OscarSR27/Neuro-inspired-Systems-Engineering-Project-1/photos_videos/mediapipe_to_VTM.jpg

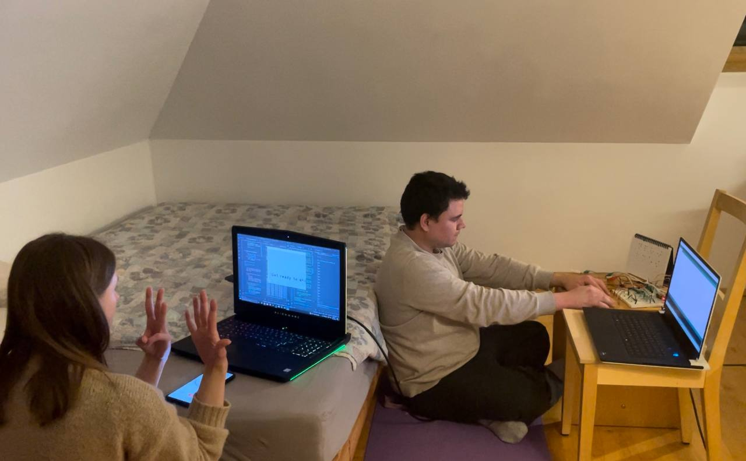
photos_videos/mediapipe_to_VTM.jpg
