OscarSR27/Neuro-inspired-Systems-Engineering-Project-1/photos_videos/Whole_system_and_laptop.jpg

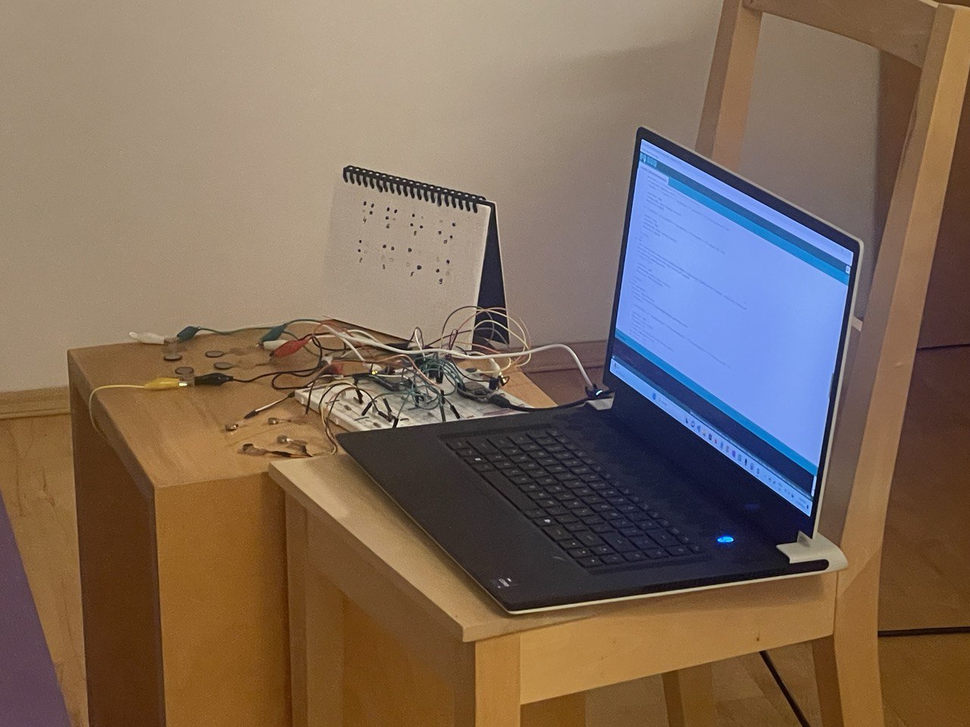
photos_videos/Whole_system_and_laptop.jpg
