OscarSR27/Neuro-inspired-Systems-Engineering-Project-1/Documentation/NISE_project-1_outline.pptx

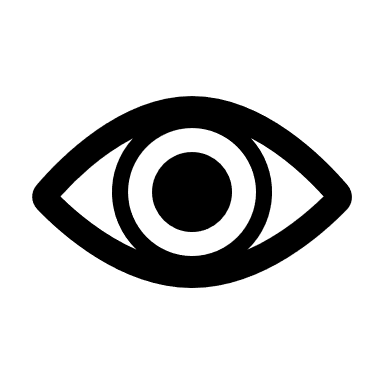
[picture p15: figure]
Auge mit einfarbiger Füllung
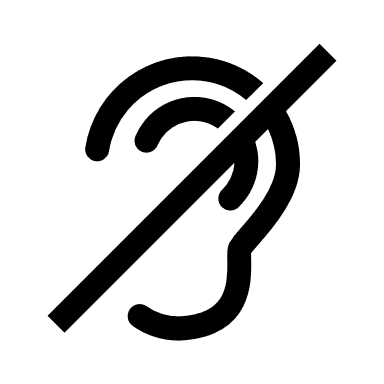
[picture p16: figure]
Taub mit einfarbiger Füllung
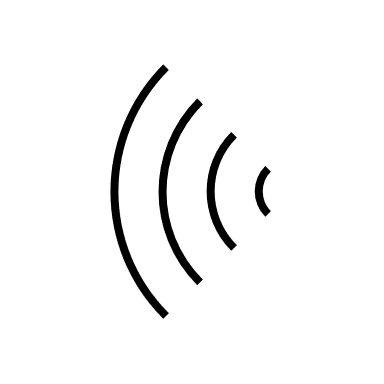
[picture p17: figure]
WLAN Silhouette
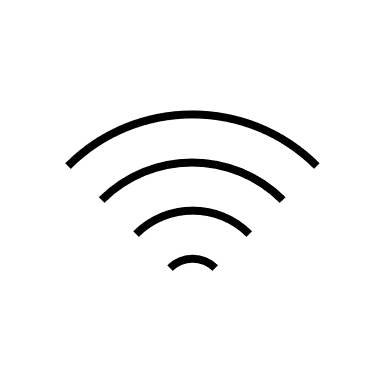
[picture p18: figure]
WLAN Silhouette
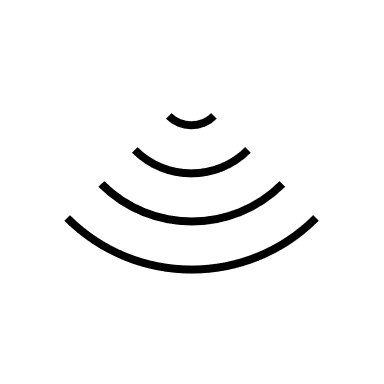
[picture p19: figure]
WLAN Silhouette
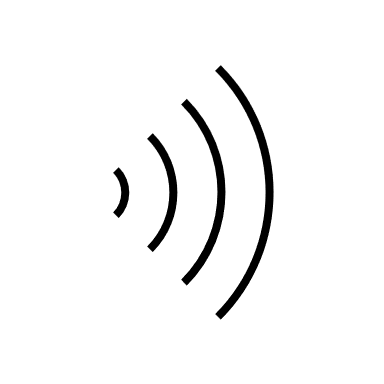
[picture p20: figure]
WLAN Silhouette

5

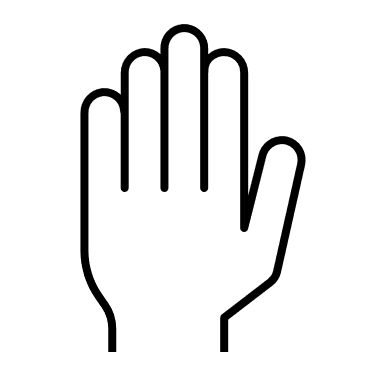
[picture p21: figure]
Erhobene Hand Silhouette
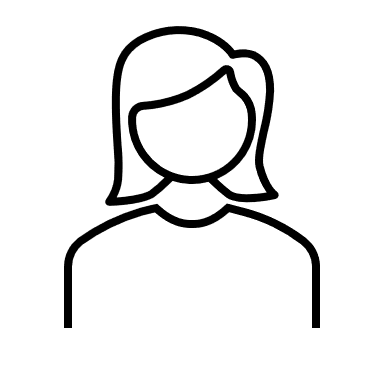
[picture p22: figure]
Weibliches Profil Silhouette
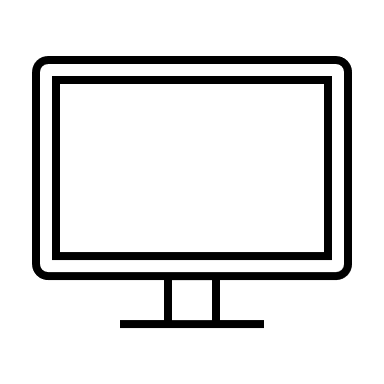
[picture p23: figure]
Monitor Silhouette
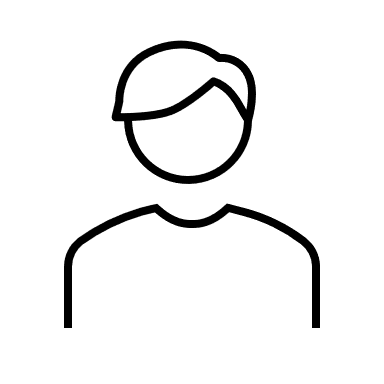
[picture p24: figure]
Männliches Profil Silhouette
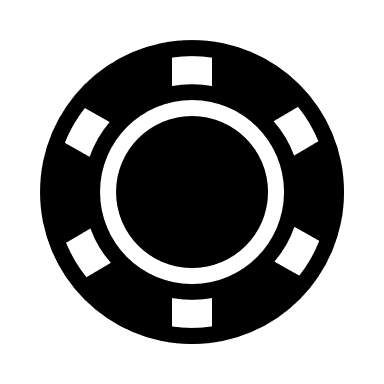
[picture p25: figure]
Glücksspielchips mit einfarbiger Füllung
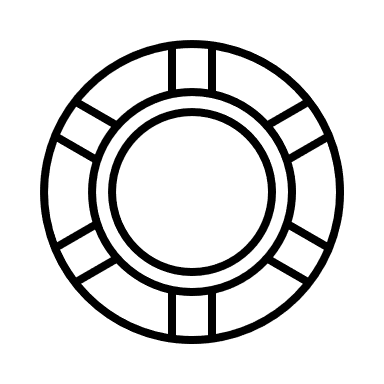
[picture p26: figure]
Glücksspielchips Silhouette

0
