OscarSR27/Neuro-inspired-Systems-Engineering-Project-1/data-analysis/plots/itr-with-acc/ACC_ITR_force_sensor_learning_curve.pdf

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

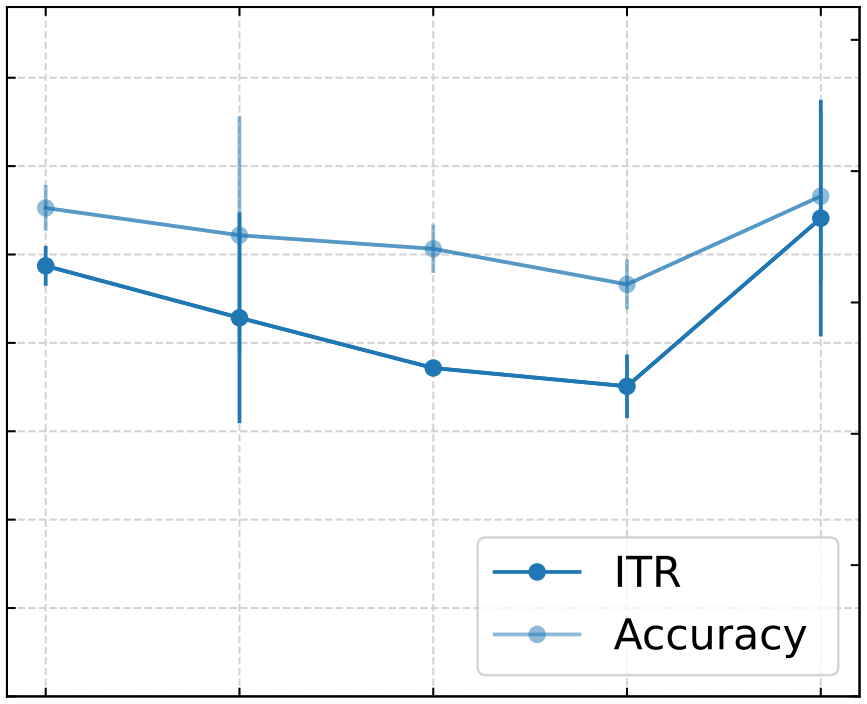
[picture p28: figure]
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
