OscarSR27/Neuro-inspired-Systems-Engineering-Project-1/data-analysis/plots/itr/ITR_force_sensor_pressure_threshold_optimization.pdf

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

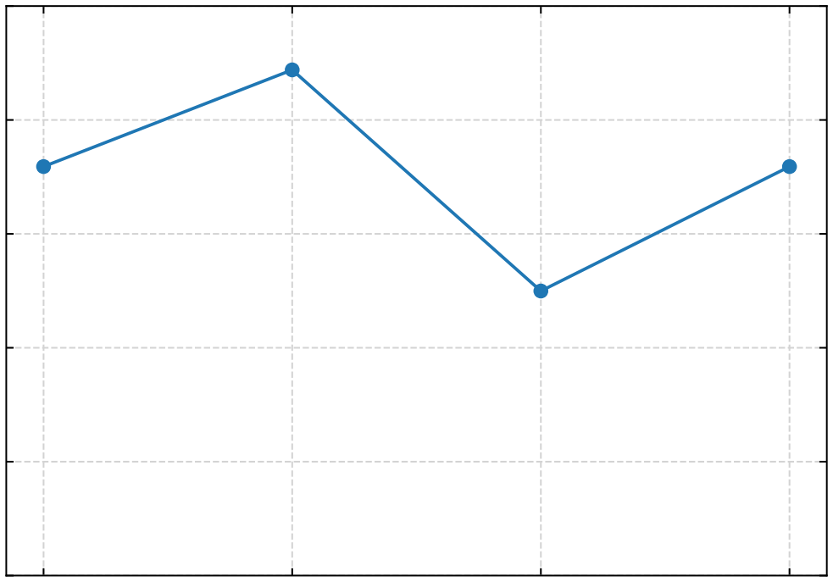
[picture p31: figure]
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
