OscarSR27/Neuro-inspired-Systems-Engineering-Project-1/data-analysis/plots/itr/ITR_force_sensor_sample_size_optimization.pdf

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

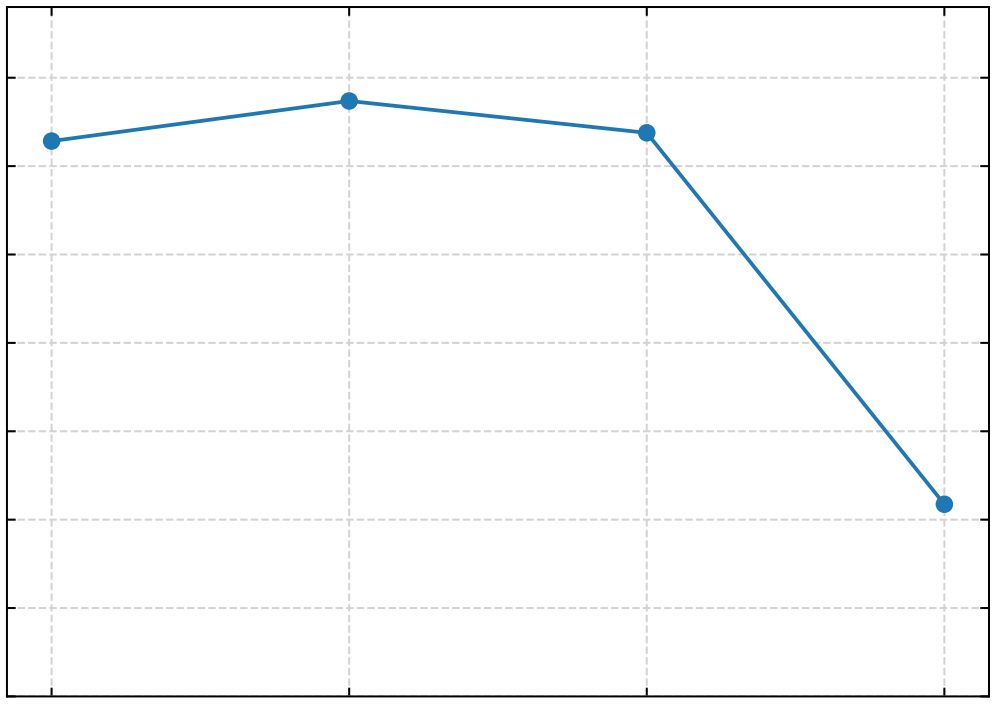
[picture p32: figure]
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
