OscarSR27/Neuro-inspired-Systems-Engineering-Project-1/data-analysis/plots/itr/ITR_vibrotactile_motors_parameter_optimization_simultaneous.pdf

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

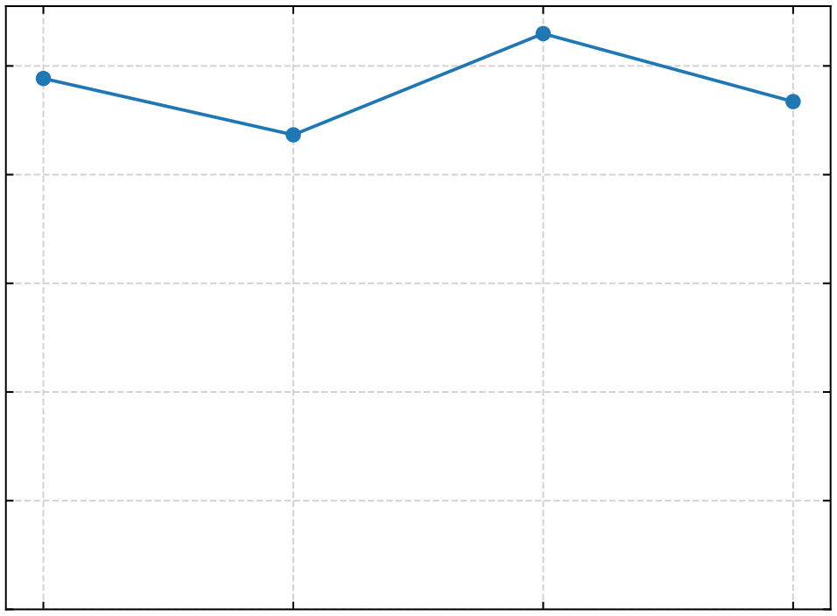
[picture p34: figure]
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
