OscarSR27/Neuro-inspired-Systems-Engineering-Project-1/photos_videos/FSR_to_mediapipe.jpg

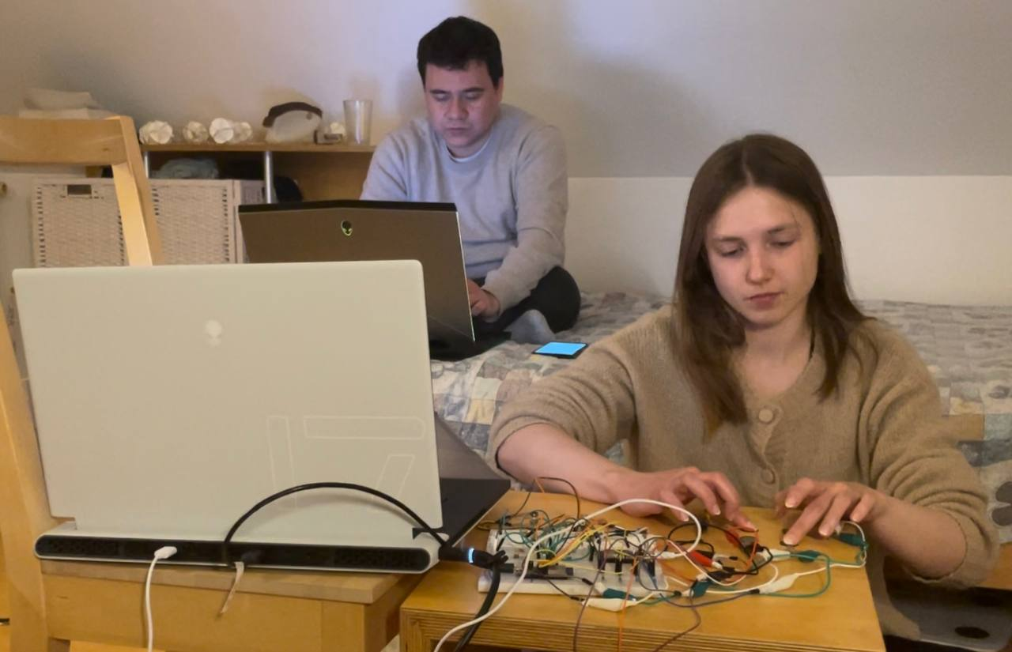
photos_videos/FSR_to_mediapipe.jpg
