OscarSR27/Neuro-inspired-Systems-Engineering-Project-1/photos_videos/FSRs.jpg

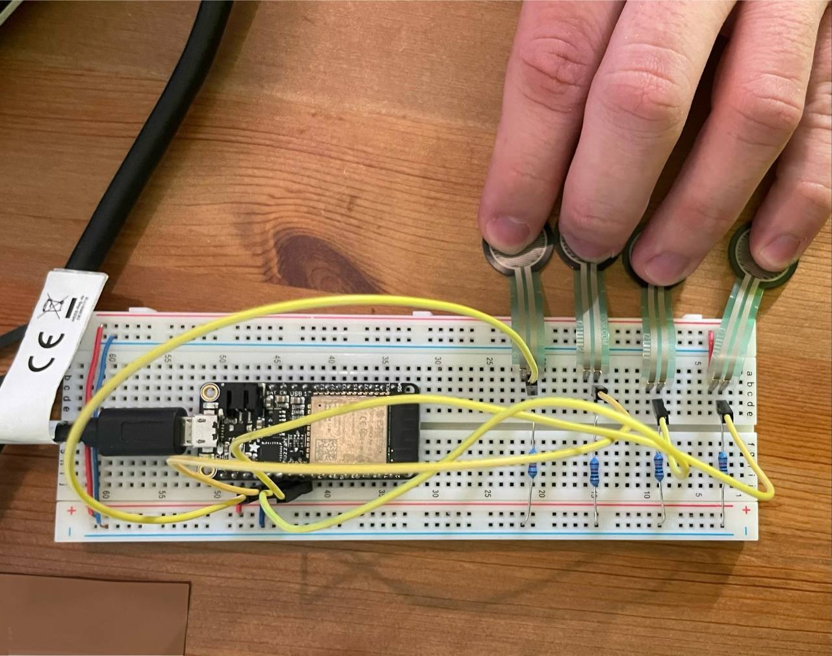
photos_videos/FSRs.jpg
