OscarSR27/Neuro-inspired-Systems-Engineering-Project-1/photos_videos/Whole_system.jpg

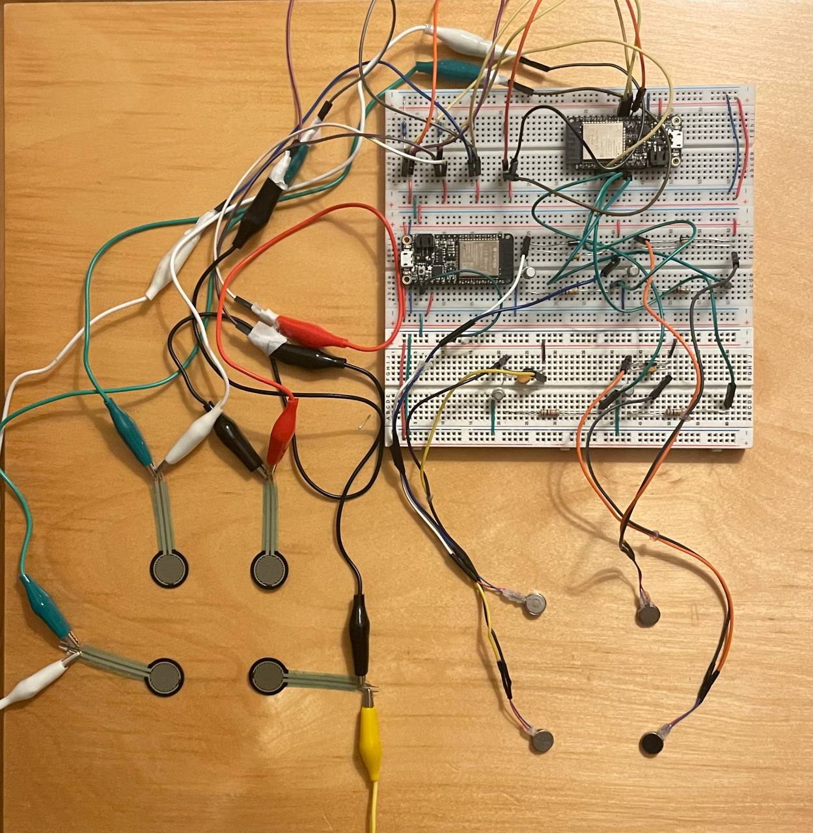
photos_videos/Whole_system.jpg
