OscarSR27/Neuro-inspired-Systems-Engineering-Project-1/photos_videos/whole_system_and_laptop_2.jpg

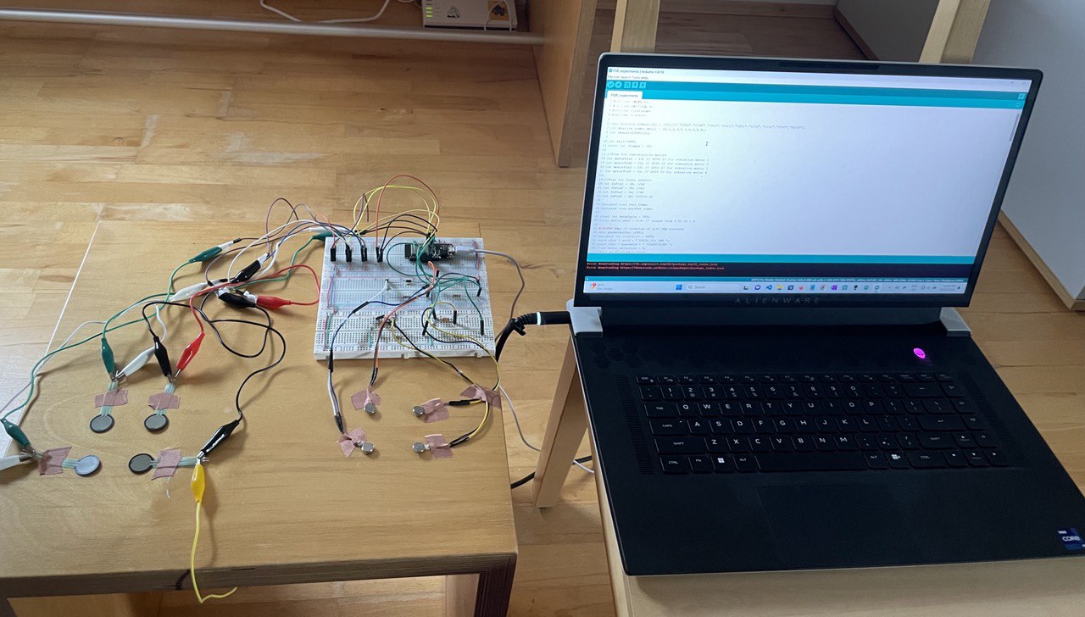
photos_videos/whole_system_and_laptop_2.jpg
