OscarSR27/Neuro-inspired-Systems-Engineering-Project-1/mediapipe/Experiment_data/subject_id0_sample_size15.csv

ground_truth | response
2 | 5
0 | 4
6 | 4
4 | 4
7 | 0
6 | 0
