OscarSR27/Neuro-inspired-Systems-Engineering-Project-1/data-analysis/accuracy_results/ACC_vibrotactile_motors_learning_curve.txt

id,pre_train,session1,session2,session3,post_train
0,0.65625,0.9148936170212766,0.88,0.9272727272727272,0.967741935483871
1,1.0,1.0,1.0,0.9803921568627451,0.9814814814814815
