OscarSR27/Neuro-inspired-Systems-Engineering-Project-1/data-analysis/itr_results/ITR_vibrotactile_motors_learning_curve.txt

id,pre_train,session1,session2,session3,post_train
0,20.8624688519472,61.85731443863901,60.30440573567301,74.67262670486284,93.43647818632834
1,73.08241808752197,76.40434618240933,81.38723832474038,79.57376244300156,84.51502554874877
