OscarSR27/Neuro-inspired-Systems-Engineering-Project-1/data-analysis/plots/itr/ITR_vibrotactile_motors_learning_curve.pdf

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

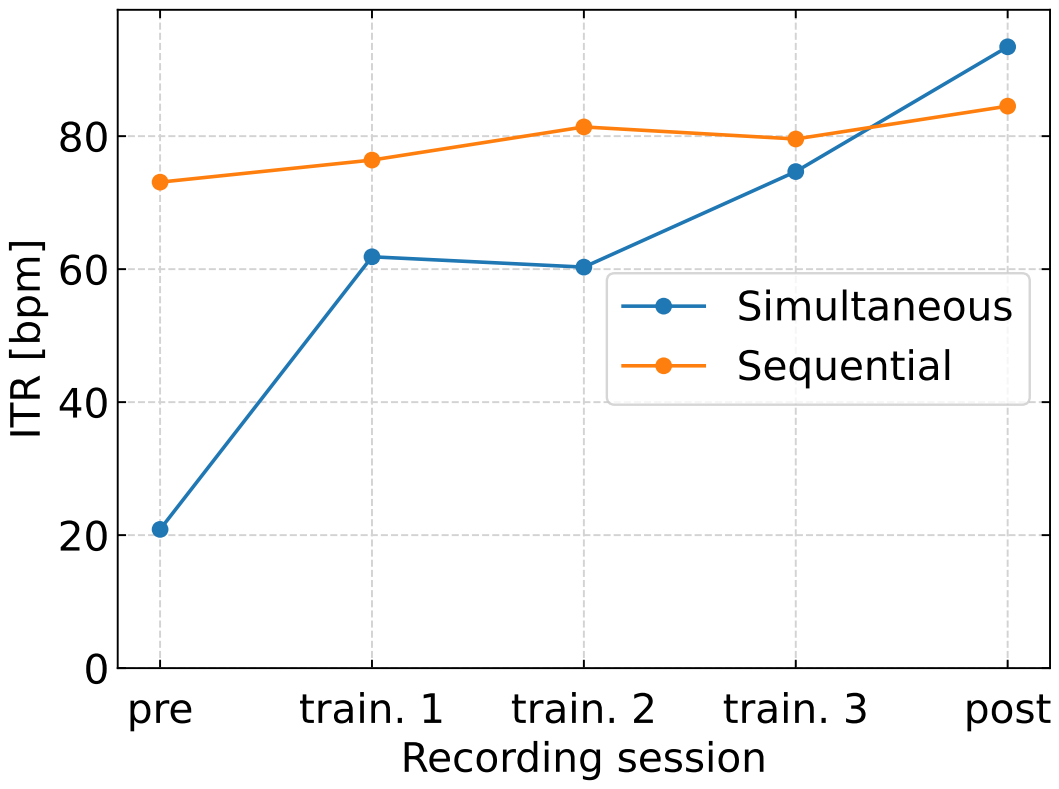
[picture p43: page 1]
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
