OscarSR27/Neuro-inspired-Systems-Engineering-Project-1/(commit log)

2023-11-26 connected python to force sensors
2023-11-26 Update ForceSensors.ino
    Update pin for force sensors
2023-11-26 Motor experiments
    Add motor experiments
2023-11-26 preliminary data analysis on dummy data
    [dummy_data_1.csv, dummy_data_2.csv]
2023-11-26 Add force sensors experiment
2023-11-26 Update motor experiments, add 2min stop
2023-11-26 Add serial vs parallel motor vibration
    [Motors_experiments.ino]
2023-11-27 added missing file subject_4_sample_5
    [subject_id4_sample_size5.csv]
2023-11-27 data analysis ITR meadipipe
    [subject_id0_sample_size10.csv, subject_id0_sample_size15.csv, subject_id0_sample_size20.csv, subject_id0_sample_size5.csv, subject_id1_sample_size10.csv, subject_id1_sample_size15.csv, subject_id1_sample_size20.csv, subject_id1_sample_size5.csv]
2023-11-28 Correct results Sasha session2
    [Motors_experiments.ino]
2023-11-29 change sample number to 15
2023-11-29 replaced serial connection with a UDP connection
    [udp_connection.py]
2023-11-30 restructured data directory for easier data loading
    [subject_id0_sample_size10.csv, subject_id0_sample_size15.csv, subject_id0_sample_size20.csv, subject_id0_sample_size5.csv, subject_id1_sample_size10.csv, subject_id1_sample_size15.csv, subject_id1_sample_size20.csv, subject_id1_sample_size5.csv]
2023-11-30 Add experiments and results for force sensors - UDP ITR
2023-11-30 data analysis ITR subsystems
    [dummy_data_1.csv, dummy_data_2.csv]
2023-12-01 complete ITR data analysis
    [ACC_mediapipe_subsystem_parameter_optimization.txt, ACC_vibrotactile_motors_parameter_optimization.txt, ITR_mediapipe_subsystem_parameter_optimization.txt, ITR_mediapipe_subsystem_parameter_optimization_mean.txt, ITR_vibrotactile_motors_parameter_optimization.txt]
2023-12-01 Add force sensor-parameter optimization using 15 frames
2023-12-03 plots with bigger font
    [ACC_mediapipe_subsystem_parameter_optimization_mean.txt]
2023-12-03 added ppt. project schematic
2023-12-03 zip folder for supplementary materials
2023-12-03 moved supplementary material pdf
